lkoehli/eqs-energy-harvesting-frontend/mcu-power-modes/results/led_off_phase.csv

duration_ms | median_uA | charge_uC
211.05 | 819.944 | 174.548
