lkoehli/eqs-energy-harvesting-frontend/mcu-power-modes/results/break_even.csv

versus | break_even_s | extra_s_per_ms_of_init
Stop 2 | 0.234 | 0.23
Stop 3 | 0.484 | 0.469
