lkoehli/eqs-energy-harvesting-frontend/mcu-power-modes/results/wakeups.csv

mode | t_s | peak_uA | duration_ms | excess_charge_uC | active_uA
Stop 2 | 10.1628 | 4243.622 | 0.22 | 0.1122 | 2228.599
Stop 3 | 10.1551 | 4130.51 | 0.2 | 0.1029 | 2250.799
Standby | 9.7556 | 14953.761 | 0.65 | 0.7811 | 2224.161
Standby | 19.7277 | 15983.874 | 0.61 | 1.1168 | 2224.161
